ademuri/power-grid/hardware/trailer-power-controller/ref/board front.png

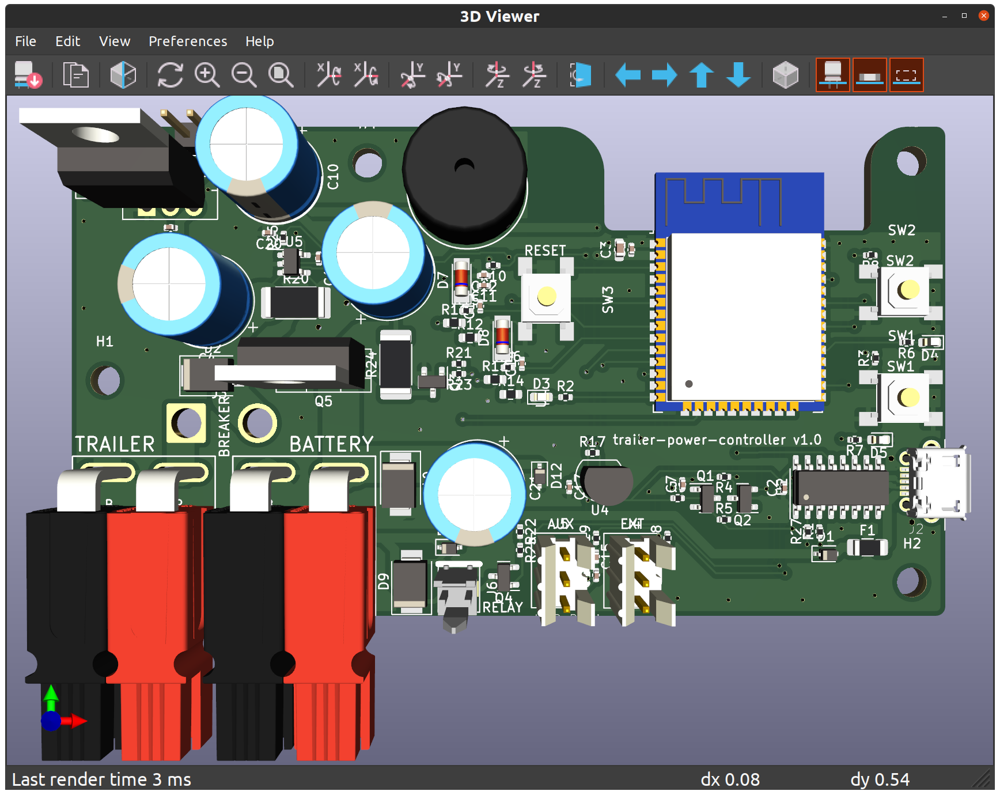
hardware/trailer-power-controller/ref/board front.png
