ademuri/power-grid/hardware/trailer-power-controller/ref/board back.png

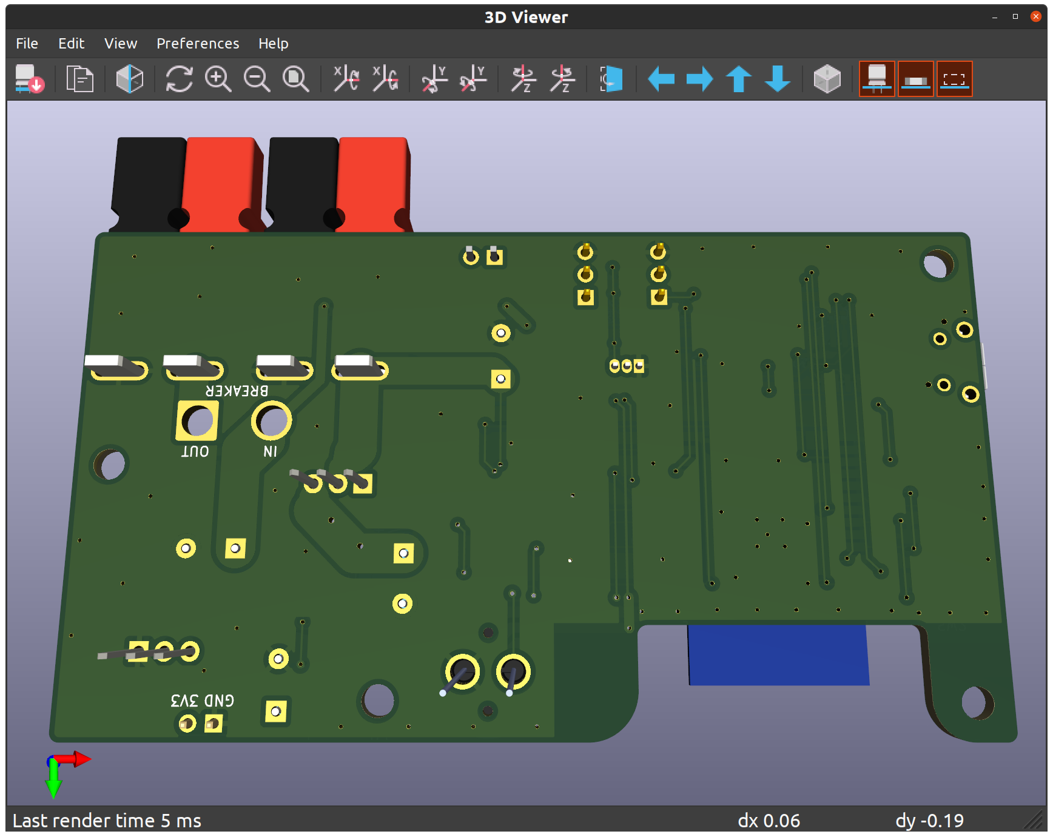
hardware/trailer-power-controller/ref/board back.png
