ademuri/power-grid/hardware/trailer-power-controller/ref/trailer-power-controller.pdf

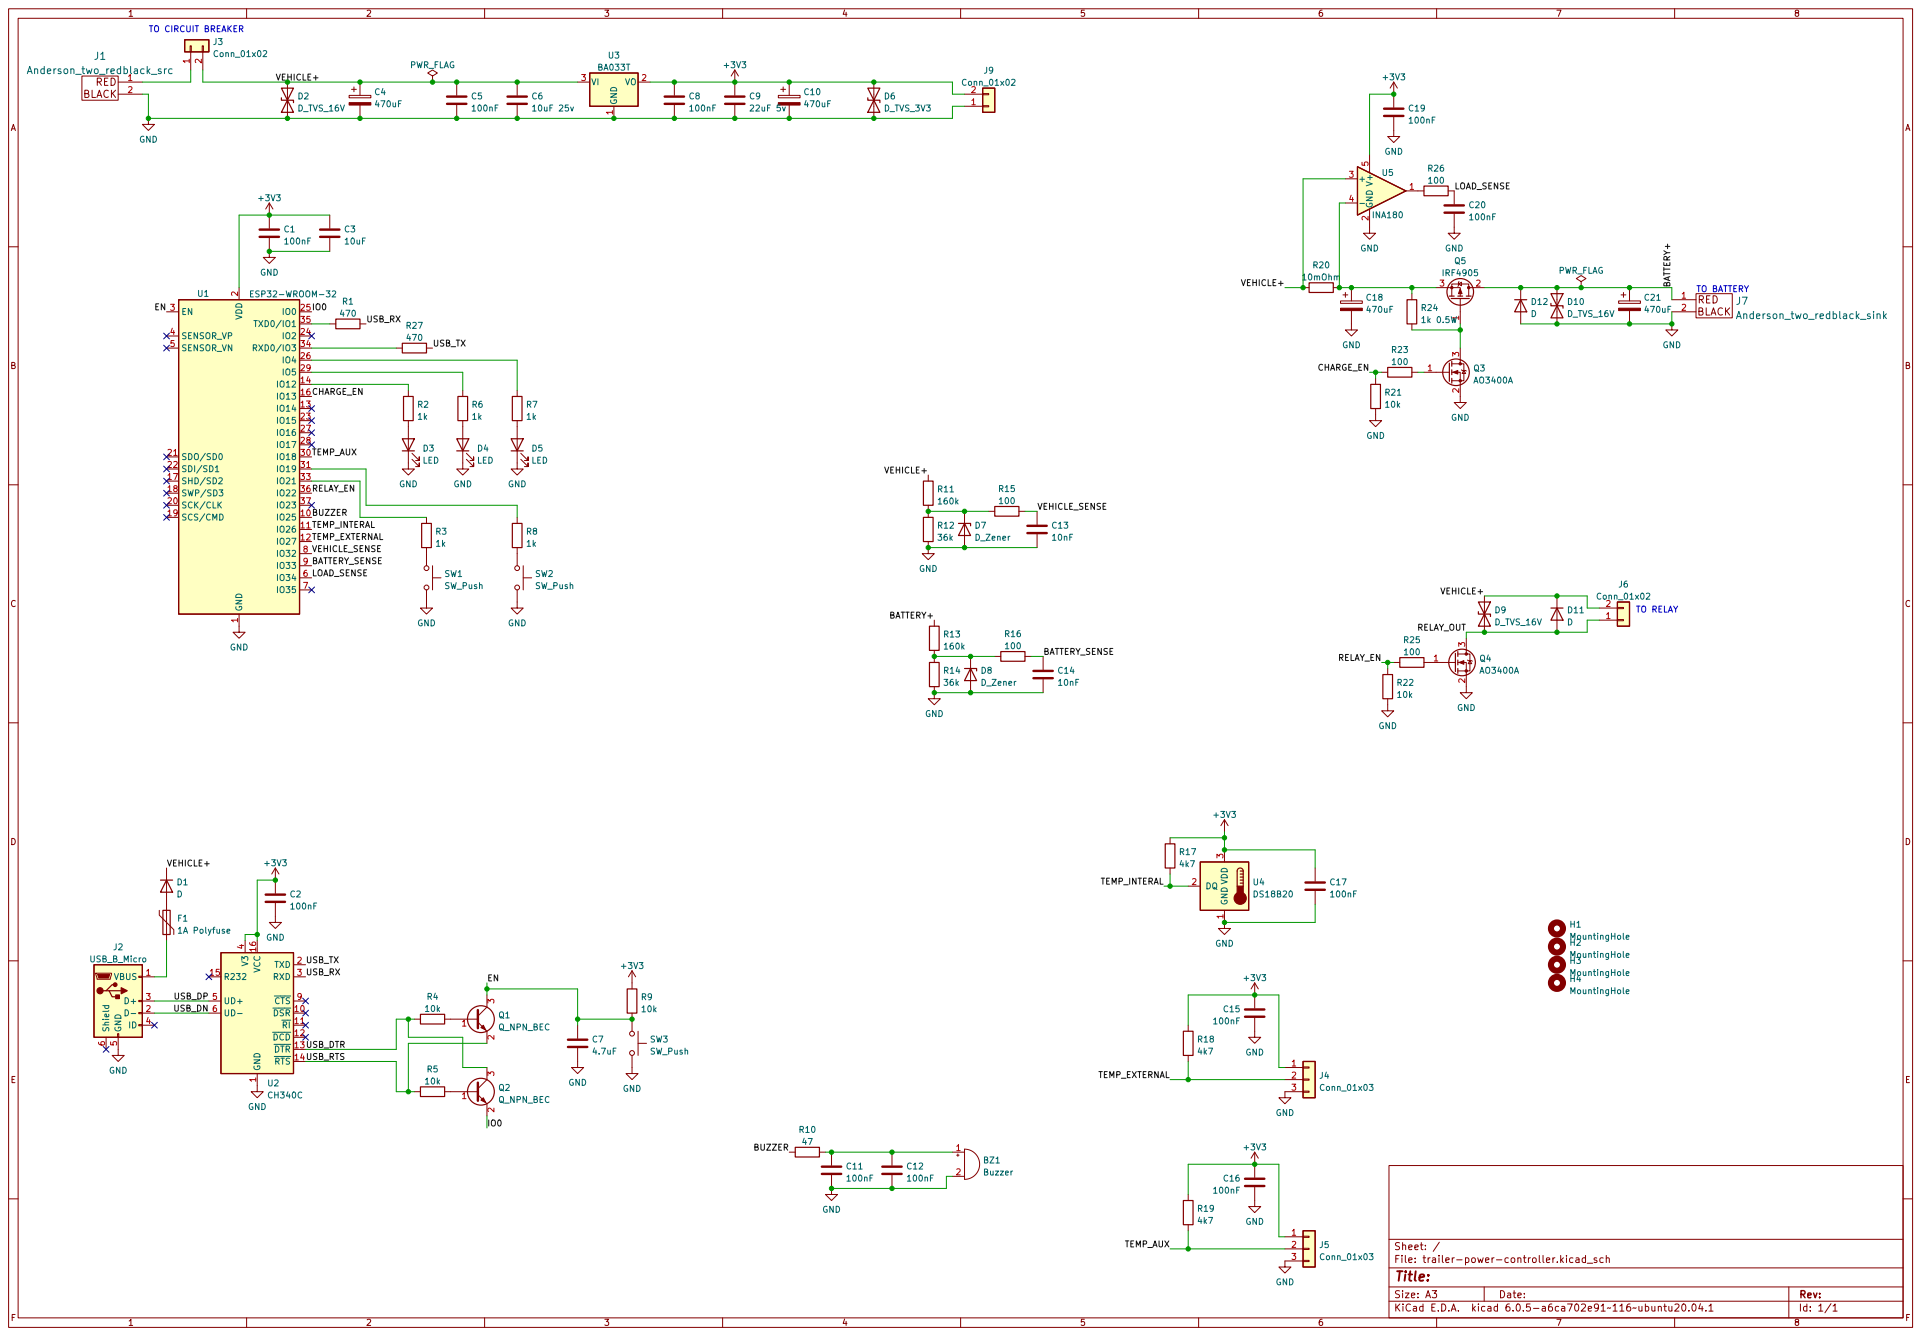
[picture p3: page 1]

2 SCK/CLK 20 SDO/SD0 21 SDI/SD1 22

1 ~{DSR}10 ~{RI}11 ~{DCD}12 ~{DTR}13 ~{RTS}14 R232 15 VCC 16 TXD 2 RXD 3 V3

File: trailer-power-controller.kicad_sch Sheet: /
