ademuri/power-grid/hardware/trailer-power-controller/trailer-power-controller.kicad_pcb

## KiCad design hardware/trailer-power-controller/trailer-power-controller.kicad_pcb (2022-07-01)

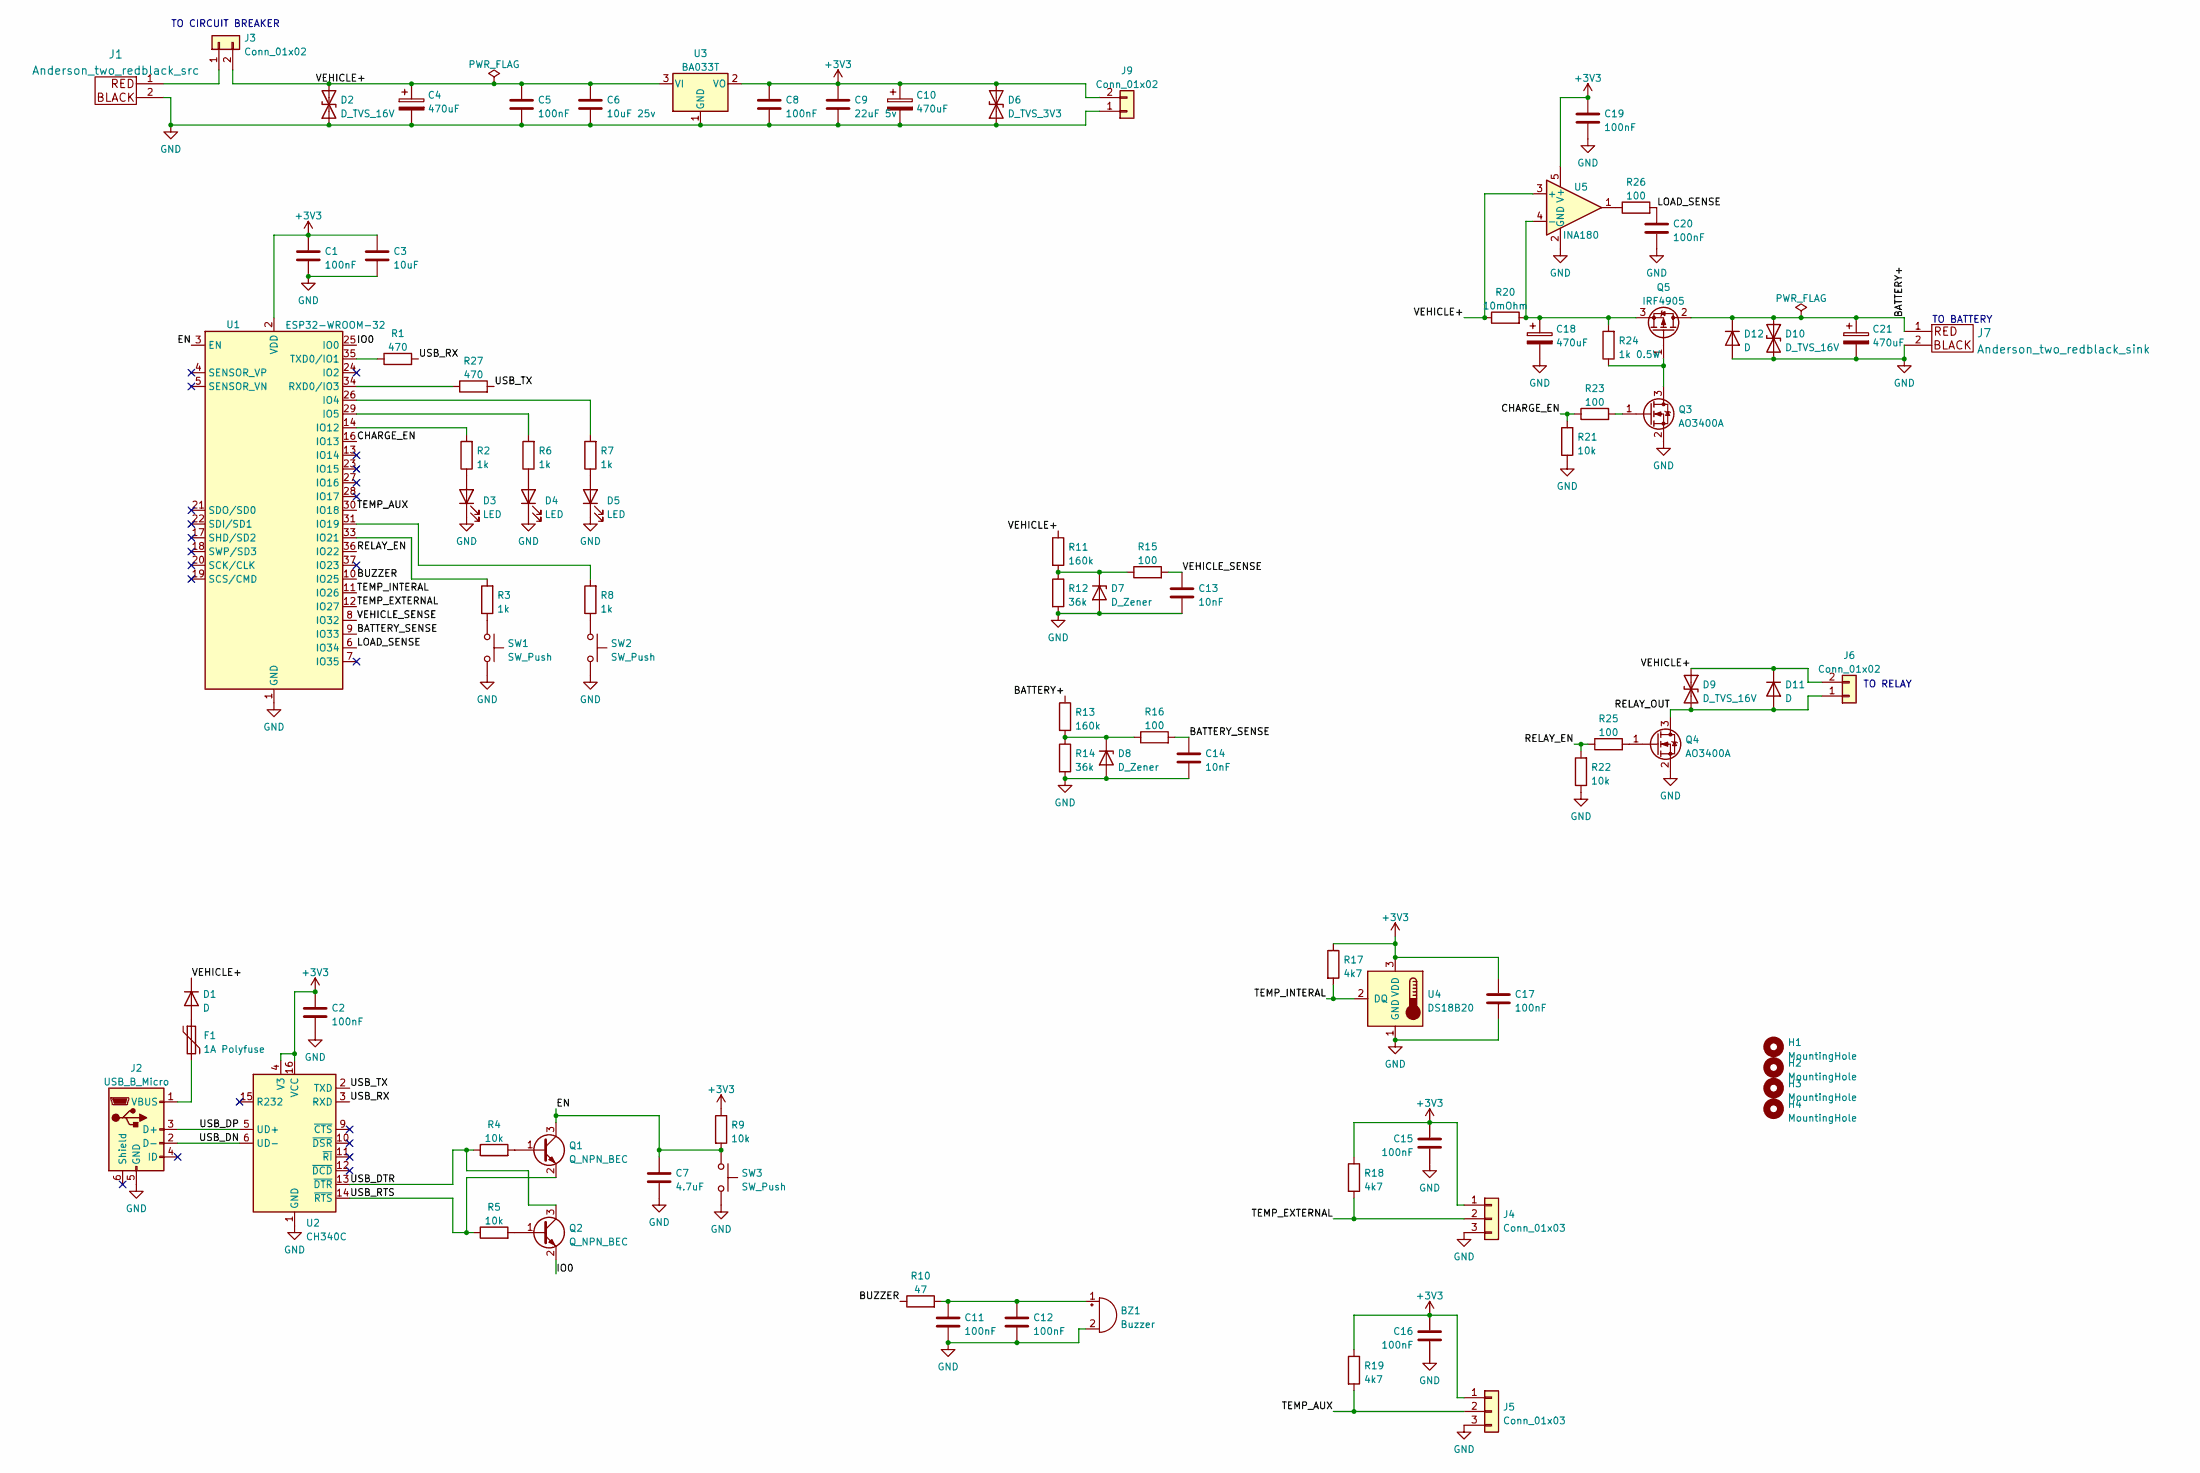
[picture p4: schematic trailer-power-controller.kicad_sch]

Parts:
BZ1: Buzzer; MURATA_PKM13EPYH4000-A0; MPN PKM13EPYH4000-A0
C1, C2, C5, C8, C11, C12, C15, C16, C17, C19, C20: 100nF; C_0402_1005Metric; LCSC C307331
C3: 10uF; C_0603_1608Metric; LCSC C96446
C4, C10, C18, C21: 470uF; CP_Radial_D10.0mm_P5.00mm
C6: 10uF 25v; C_0805_2012Metric; LCSC C440198
C7: 4.7uF; C_0402_1005Metric; LCSC C23733
C9: 22uF 5v; C_1206_3216Metric; LCSC C12891
C13, C14: 10nF; C_0402_1005Metric; LCSC C15195
D1, D11, D12: D; D_SOD-323; LCSC C191023
D2, D9, D10: D_TVS_16V; D_SMB; MPN SMBJ16CA
D3, D4, D5: LED; LED_0603_1608Metric; LCSC C2286
D6: D_TVS_3V3; D_SMB; MPN SMBJ4CA
D7, D8: D_Zener; D_MiniMELF; LCSC C8056
F1: 1A Polyfuse; Fuse_1206_3216Metric_Pad1.42x1.75mm_HandSolder; MPN PTS12066V100
H1, H2, H3, H4: MountingHole; MountingHole_3.2mm_M3
J1: Anderson_two_redblack_src; Anderson_1336G1_right_angle_bottom_two
J2: USB_B_Micro; FRAMATOME_10118194-0001LF_fixed_bridges; LCSC C132563
J3: Conn_01x02; SolderWire-12AWG_1x02; MPN W51-A152A1-15
J4, J5: Conn_01x03; MiniPV_69167-X03XXX_1x03_P2.54mm_Polarized_Vertical
J6: Conn_01x02; MiniPV_76384-X02XX_1x02_P2.54mm_Vertical
J7: Anderson_two_redblack_sink; Anderson_1336G1_right_angle_bottom_two
J9: Conn_01x02; PinHeader_1x02_P2.54mm_Vertical
Q1, Q2: Q_NPN_BEC; SOT-23; LCSC C2150
Q3, Q4: AO3400A; SOT-23; LCSC C20917
Q5: IRF4905; TO-220-3_Vertical; MPN IRF4905PBF
R1, R27: 470; R_0402_1005Metric; LCSC C25117
R2, R3, R6, R7, R8: 1k; R_0402_1005Metric; LCSC C11702
R4, R5, R9, R21, R22: 10k; R_0402_1005Metric; LCSC C25744
R10: 47; R_0402_1005Metric; LCSC C25118
R11, R13: 160k; R_0603_1608Metric; LCSC C22813
R12, R14: 36k; R_0603_1608Metric; LCSC C23147
R15, R16, R23, R25, R26: 100; R_0402_1005Metric; LCSC C25076
R17, R18, R19: 4k7; R_0402_1005Metric; LCSC C25900
R20: 10mOhm; R_2512_6332Metric_Pad1.40x3.35mm_HandSolder; MPN CRA2512-FZ-R010ELF
R24: 1k 0.5W; R_2512_6332Metric_Pad1.40x3.35mm_HandSolder; MPN CRM2512-JW-102ELF
SW1, SW2, SW3: SW_Push; SW_TACTILE_5.1MM_TS-1187A-C-D-B; LCSC C318884
U1: ESP32-WROOM-32; MPN ESP32-WROOM-32E-N4
U2: CH340C; SOIC-16_3.9x9.9mm_P1.27mm; LCSC C84681
U3: BA033T; TO-220-3_Vertical; MPN BA033T
U4: DS18B20; TO-92_Inline; MPN DS18B20
U5: INA180; SOT-23-5; MPN INA180A1IDBVR; LCSC C192764

Connections:
+3V3: C1.1, C2.2, C3.1, C8.1, C9.1, C10.1, C15.1, C16.1, C17.1, C19.1, D6.2 (A2), J4.1, J5.1, J9.2, R9.1, R17.1, R18.1, R19.1, U1.2 (VDD), U2.4 (V3), U2.16 (VCC), U3.2 (VO), U4.3 (VDD), U5.5 (V+)
/BATTERY+: C21.1, D10.1 (A1), D12.1 (K), J7.1, Q5.2 (D), R13.1
/BATTERY_SENSE: C14.1, R16.2, U1.9 (IO33)
/BUZZER: R10.1, U1.10 (IO25)
/CHARGE_EN: R21.2, R23.1, U1.16 (IO13)
/EN: C7.1, Q1.3 (C), R9.2, SW3.1, U1.3 (EN)
/IO0: Q2.2 (E), U1.25 (IO0)
/LOAD_SENSE: C20.1, R26.2, U1.6 (IO34)
/RELAY_EN: R22.2, R25.1, U1.36 (IO22)
/RELAY_OUT: D9.2 (A2), D11.2 (A), J6.1, Q4.3 (D)
/TEMP_AUX: J5.2, R19.2, U1.30 (IO18)
/TEMP_EXTERNAL: J4.2, R18.2, U1.12 (IO27)
/TEMP_INTERAL: R17.2, U1.11 (IO26), U4.2 (DQ)
/USB_DN: J2.2 (D-), U2.6 (UD-)
/USB_DP: J2.3 (D+), U2.5 (UD+)
/USB_DTR: Q2.3 (C), R4.1, U2.13 (~DTR)
/USB_RTS: Q1.2 (E), R5.1, U2.14 (~RTS)
/USB_RX: R1.2, U2.3 (RXD)
/USB_TX: R27.2, U2.2 (TXD)
/VEHICLE+: C4.1, C5.1, C6.1, D1.1 (K), D2.2 (A2), D9.1 (A1), D11.1 (K), J3.2, J6.2, R11.1, R20.1, U3.3 (VI), U5.3 (+)
/VEHICLE_SENSE: C13.1, R15.2, U1.8 (IO32)
GND: BZ1.2 (+), C1.2, C2.1, C3.2, C4.2, C5.2, C6.2, C7.2, C8.2, C9.2, C10.2, C11.2, C12.2, C13.2, C14.2, C15.2, C16.2, C17.2, C18.2, C19.2, C20.2, C21.2, D2.1 (A1), D3.1 (K), D4.1 (K), D5.1 (K), D6.1 (A1), D7.2 (A), D8.2 (A), D10.2 (A2), D12.2 (A), J1.2, J2.5 (GND), J4.3, J5.3, J7.2, J9.1, Q3.2 (S), Q4.2 (S), R12.2, R14.2, R21.1, R22.1, SW1.2, SW2.2, SW3.2, U1.1 (GND), U1.15 (GND), U1.38 (GND), U1.39 (GND), U2.1 (GND), U3.1 (GND), U4.1 (GND), U5.2 (GND)
unnamed: BZ1.1 (-), C11.1, C12.1, R10.2
unnamed: C18.1, Q5.3 (S), R20.2, R24.2, U5.4 (-)
unnamed: D1.2 (A), F1.1
unnamed: D3.2 (A), R2.1
unnamed: D4.2 (A), R6.1
unnamed: D5.2 (A), R7.1
unnamed: D7.1 (K), R11.2, R12.1, R15.1
unnamed: D8.1 (K), R13.2, R14.1, R16.1
unnamed: F1.2, J2.1 (VBUS)
unnamed: J1.1, J3.1
unnamed: Q1.1 (B), R4.2
unnamed: Q2.1 (B), R5.2
unnamed: Q3.1 (G), R23.2
unnamed: Q3.3 (D), Q5.1 (G), R24.1
unnamed: Q4.1 (G), R25.2
unnamed: R1.1, U1.35 (TXD0/IO1)
unnamed: R2.2, U1.14 (IO12)
unnamed: R3.1, SW1.1
unnamed: R3.2, U1.33 (IO21)
unnamed: R6.2, U1.29 (IO5)
unnamed: R7.2, U1.26 (IO4)
unnamed: R8.1, SW2.1
unnamed: R8.2, U1.31 (IO19)
unnamed: R26.1, U5.1
unnamed: R27.1, U1.34 (RXD0/IO3)

Notes on the sheet:
TO RELAY
TO BATTERY
TO CIRCUIT BREAKER

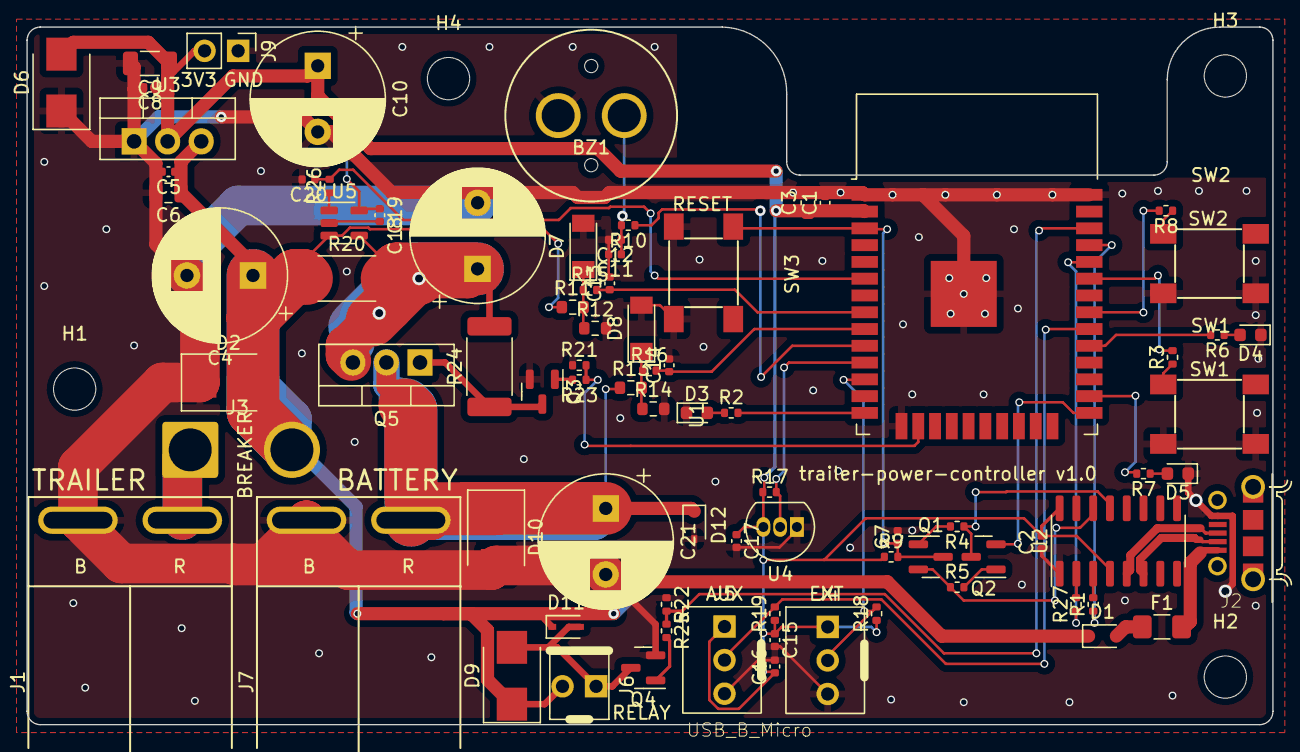
[picture p5: board trailer-power-controller.kicad_pcb from above]

Board: 2 copper layers, 94.3 x 52.8 mm, 87 parts (0 on the bottom side), 47 nets.
