ademuri/power-grid/(commit log)

2022-06-27 Add schematic and placement for trailer power controller
    [trailer-power-controller.kicad_pcb, trailer-power-controller.kicad_sch]
2022-06-28 trailer-power-controller hardware v1.0
    [trailer-power-controller-B_Cu.gbl, trailer-power-controller-B_Mask.gbs, trailer-power-controller-B_Paste.gbp, trailer-power-controller-B_Silkscreen.gbo, trailer-power-controller-Edge_Cuts.gm1, trailer-power-controller-F_Cu.gtl, trailer-power-controller-F_Mask.gts, trailer-power-controller-F_Paste.gtp]
2022-07-01 Pre-fab hardware v1.0 fixes
    [trailer-power-controller-B_Cu.gbl, trailer-power-controller-B_Mask.gbs, trailer-power-controller-B_Paste.gbp, trailer-power-controller-B_Silkscreen.gbo, trailer-power-controller-Edge_Cuts.gm1, trailer-power-controller-F_Cu.gtl, trailer-power-controller-F_Mask.gts, trailer-power-controller-F_Paste.gtp]
2022-07-21 Move PCB to subdir and create basic PIO project
    [trailer-power-controller-B_Cu.gbl, trailer-power-controller-B_Mask.gbs, trailer-power-controller-B_Paste.gbp, trailer-power-controller-B_Silkscreen.gbo, trailer-power-controller-Edge_Cuts.gm1, trailer-power-controller-F_Cu.gtl, trailer-power-controller-F_Mask.gts, trailer-power-controller-F_Paste.gtp]
2022-07-22 Add pin definitions
2022-07-23 Fix voltage detection
2022-07-23 Add basic power transfer logic
2022-07-23 Wait for battery to be low for some time before turning it off
2022-07-24 Check vehicle floating voltage
2022-08-08 Add battery min detection
2022-08-15 Add 3d model for pcb
2022-08-16 Reset the inverter periodically
    [trailer-power-monitor.ino]
2022-08-16 Add internal temp, and blink alive LED
2022-08-18 Fix crashes, add OTA
    [trailer-power-monitor.ino]
2022-08-24 Also reset inverter at startup
    [trailer-power-monitor.ino]
